KenWillmott/M8-Game-Board/IMG_20230915_113249.jpg

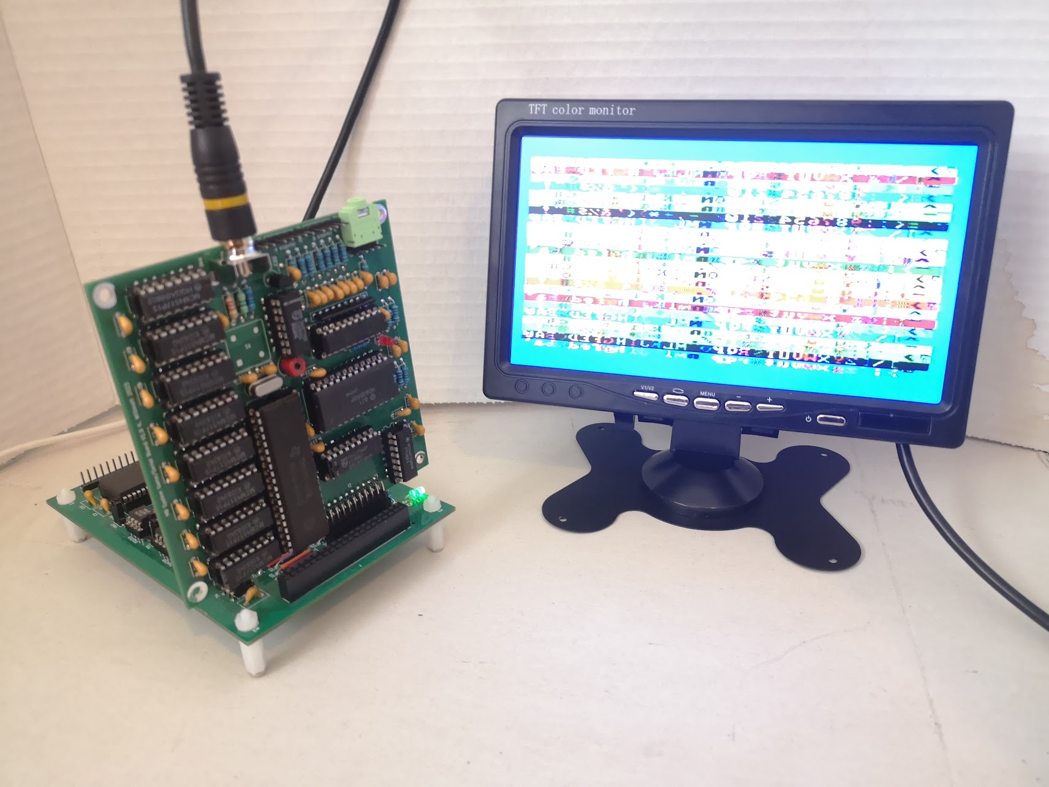
IMG_20230915_113249.jpg
