KenWillmott/M8-Game-Board/IMG_20230915_120120.jpg

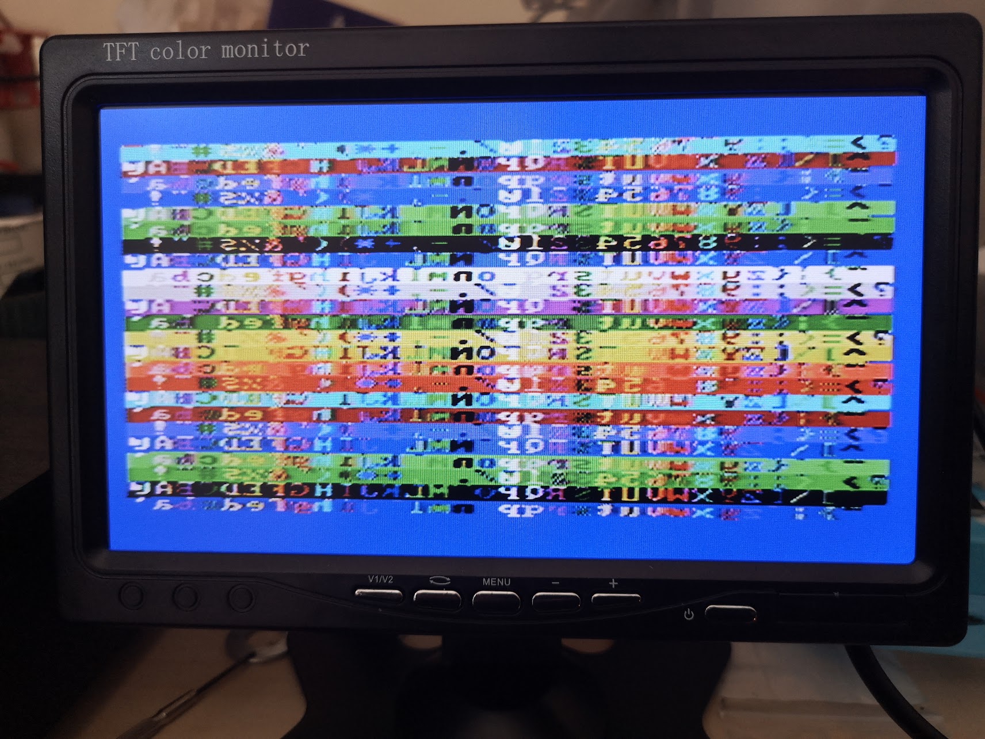
IMG_20230915_120120.jpg
