KenWillmott/M8-Game-Board/README.md

# M8-Game-Board

## Note: This board is deprecated, an improved board is in testing.

See: https://github.com/KenWillmott/M8-Game-Board-V2.1

The M8 Game Board is so named because it combines a video display processor, a sound synthesizer, and dual joystick inputs. These are the main components of a video game. Keyboard input is also possible with the serial chip that is also on board. It also follows the M8 philosophy of using the most advanced ICs that were available at the time, without regard to brand.

The TMS9918A VDP (Video Display Processor) was certainly the IC that brought game features like hardware sprites (up to 32) and using cheap (at the time) dynamic memory. Steve Ciarcia's article about it inspired an Apple II compatible video expansion card that I happened to get a hold of and interfaced to my Ohio Scientific Superboard II. It was lost, and this is a great way to play with it again. It's an amazing chip, and also extremely simple to interface to an 8 bit processor.

The synth was a tough choice because it factors in my judgement of the current availability, combined with interface ease issues. But I played with a prototype and it can make game quality music and effects. It's the Philips SAA1099. The more common AY-8910 was ruled out because of interface issues.

The joystick inputs are just a pair of 4 filtered digital inputs to a latch, with resistor pull ups to the power supply. So they can also be any eight general purpose switches.

The serial interface is an MC6850 or equivalent part. It's a UART but Motorola called it an "ACIA". There are now small USB Host to Serial cards available, it would allow the input from a keyboard and maybe mouse.

One board has been built and tested. Evaluation is on going.

See the wiki for more details:
https://github.com/KenWillmott/M8-Game-Board/wiki
