KenWillmott/M8-Game-Board/motorino-game.pdf

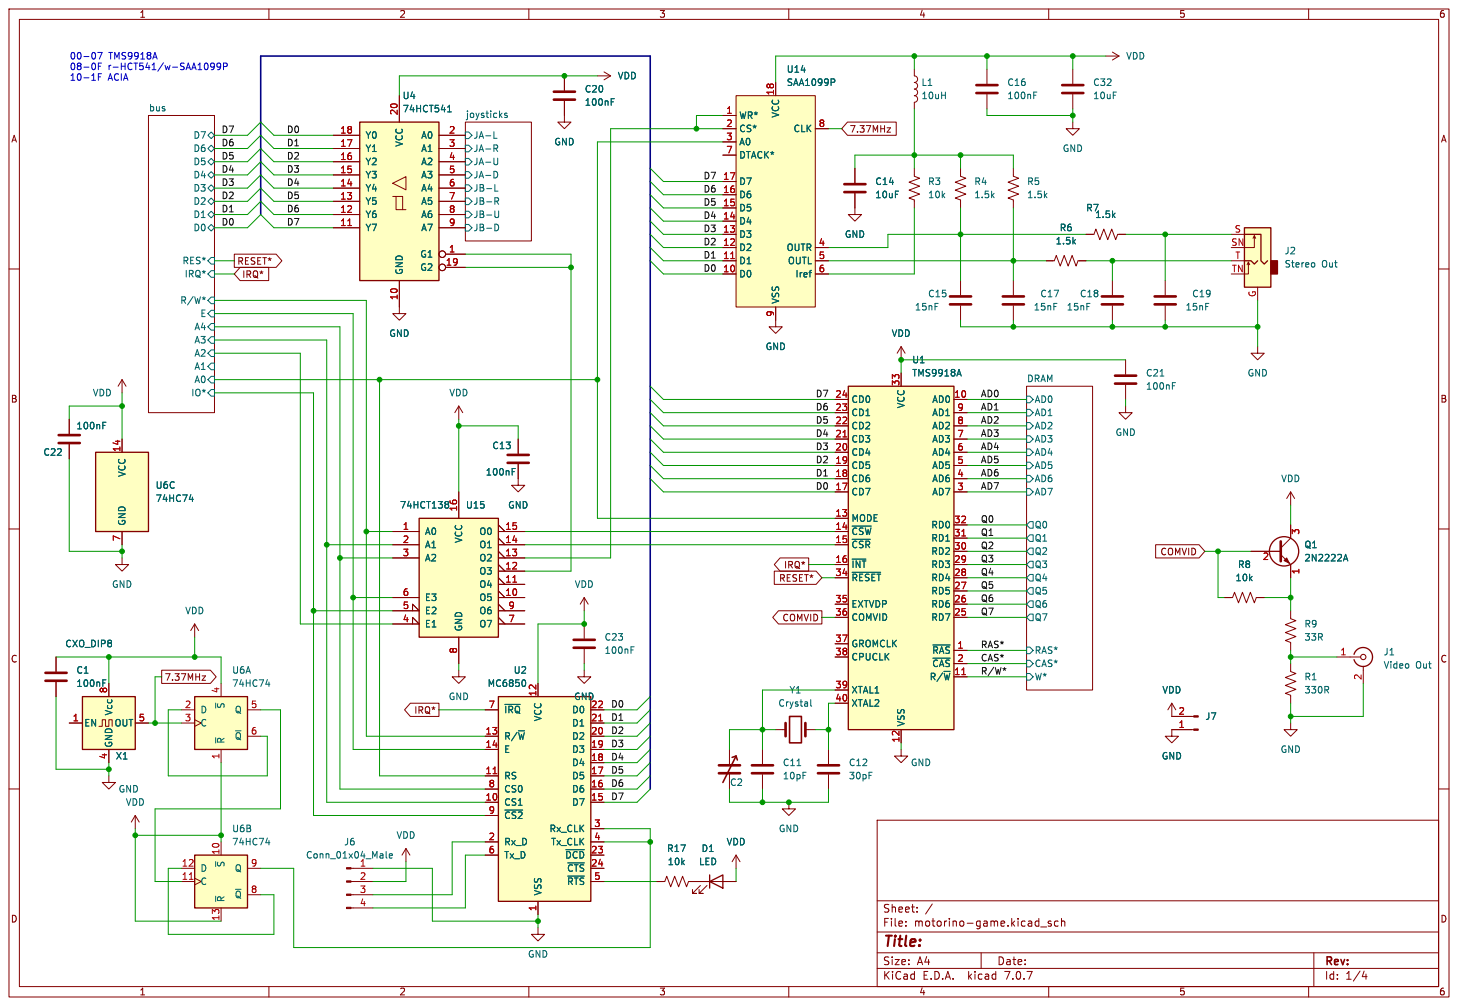
[picture p3: page 1]

Id: 1/4 Title: File: motorino-game.kicad_sch Sheet: /

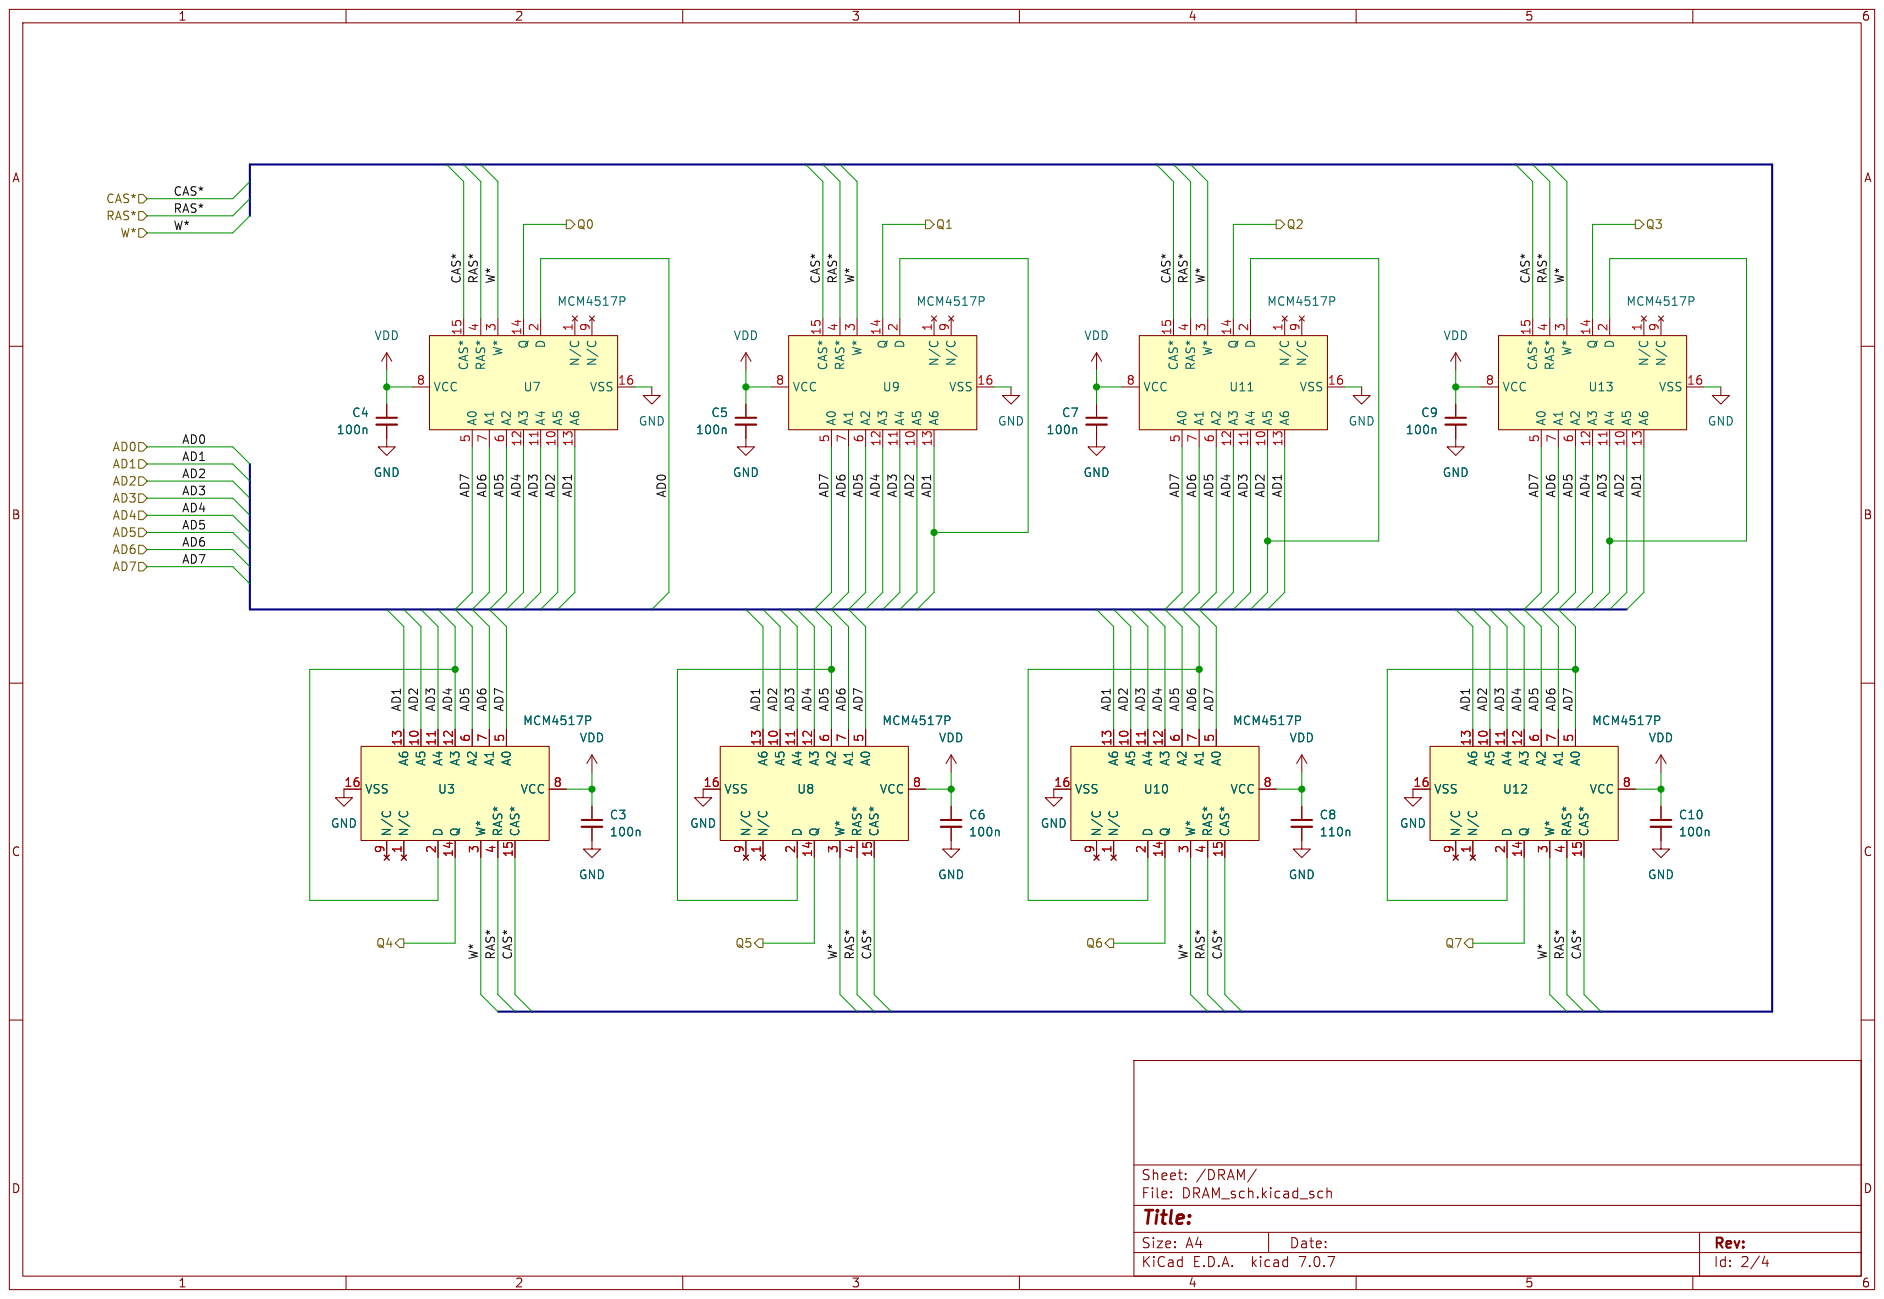
[picture p4: page 2]

Id: 2/4 Title: File: DRAM_sch.kicad_sch Sheet: /DRAM/ N/C

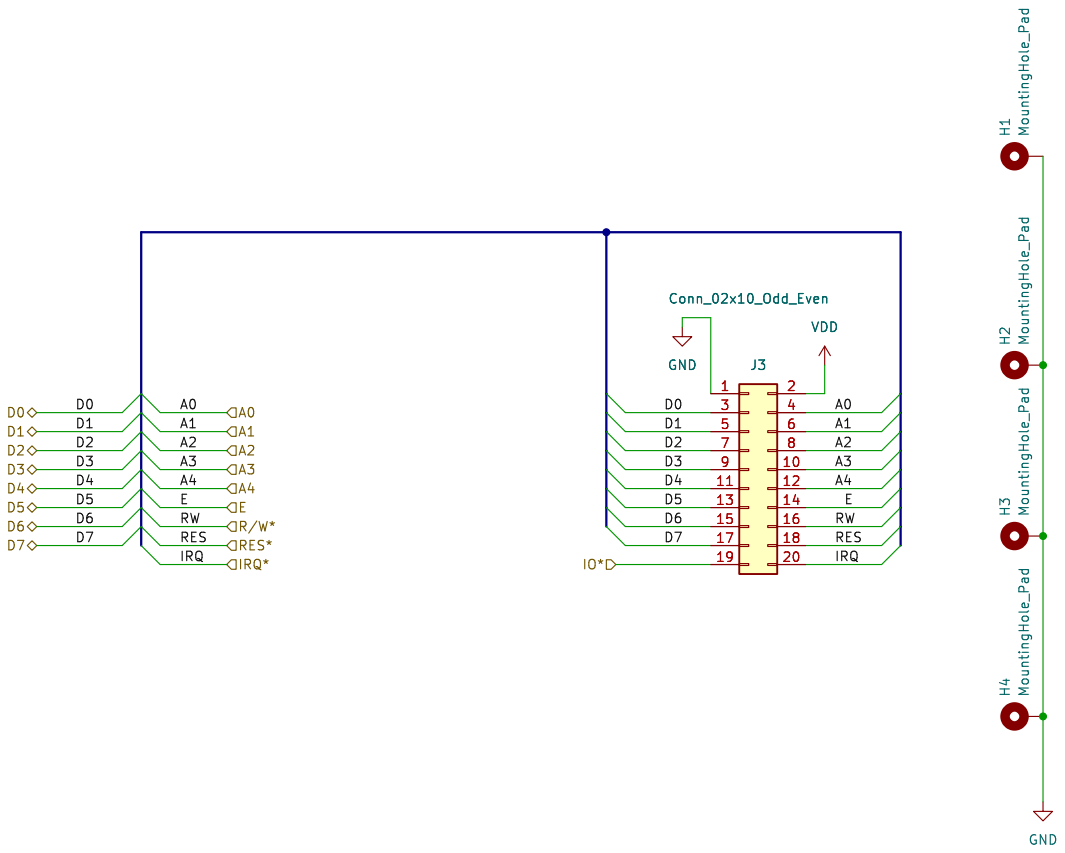
[picture p5: page 3]

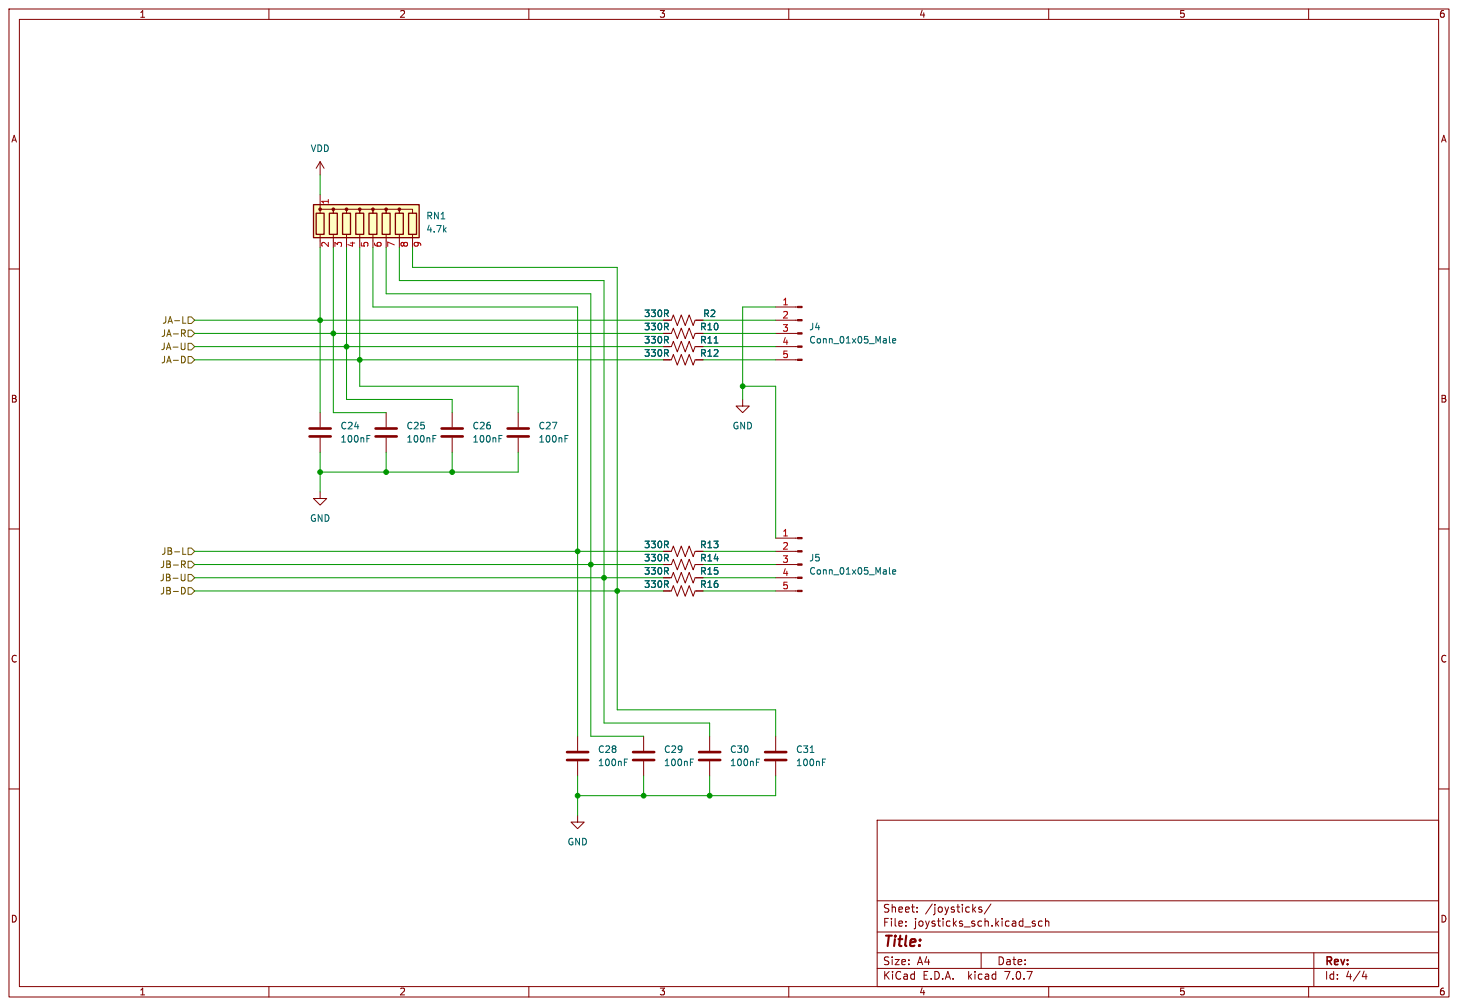
[picture p6: page 4]

Id: 4/4 Title: File: joysticks_sch.kicad_sch Sheet: /joysticks/ C28
