KenWillmott/M8-Game-Board/DRAM_sch.kicad_sch

## KiCad design DRAM_sch.kicad_sch (2023-09-16)

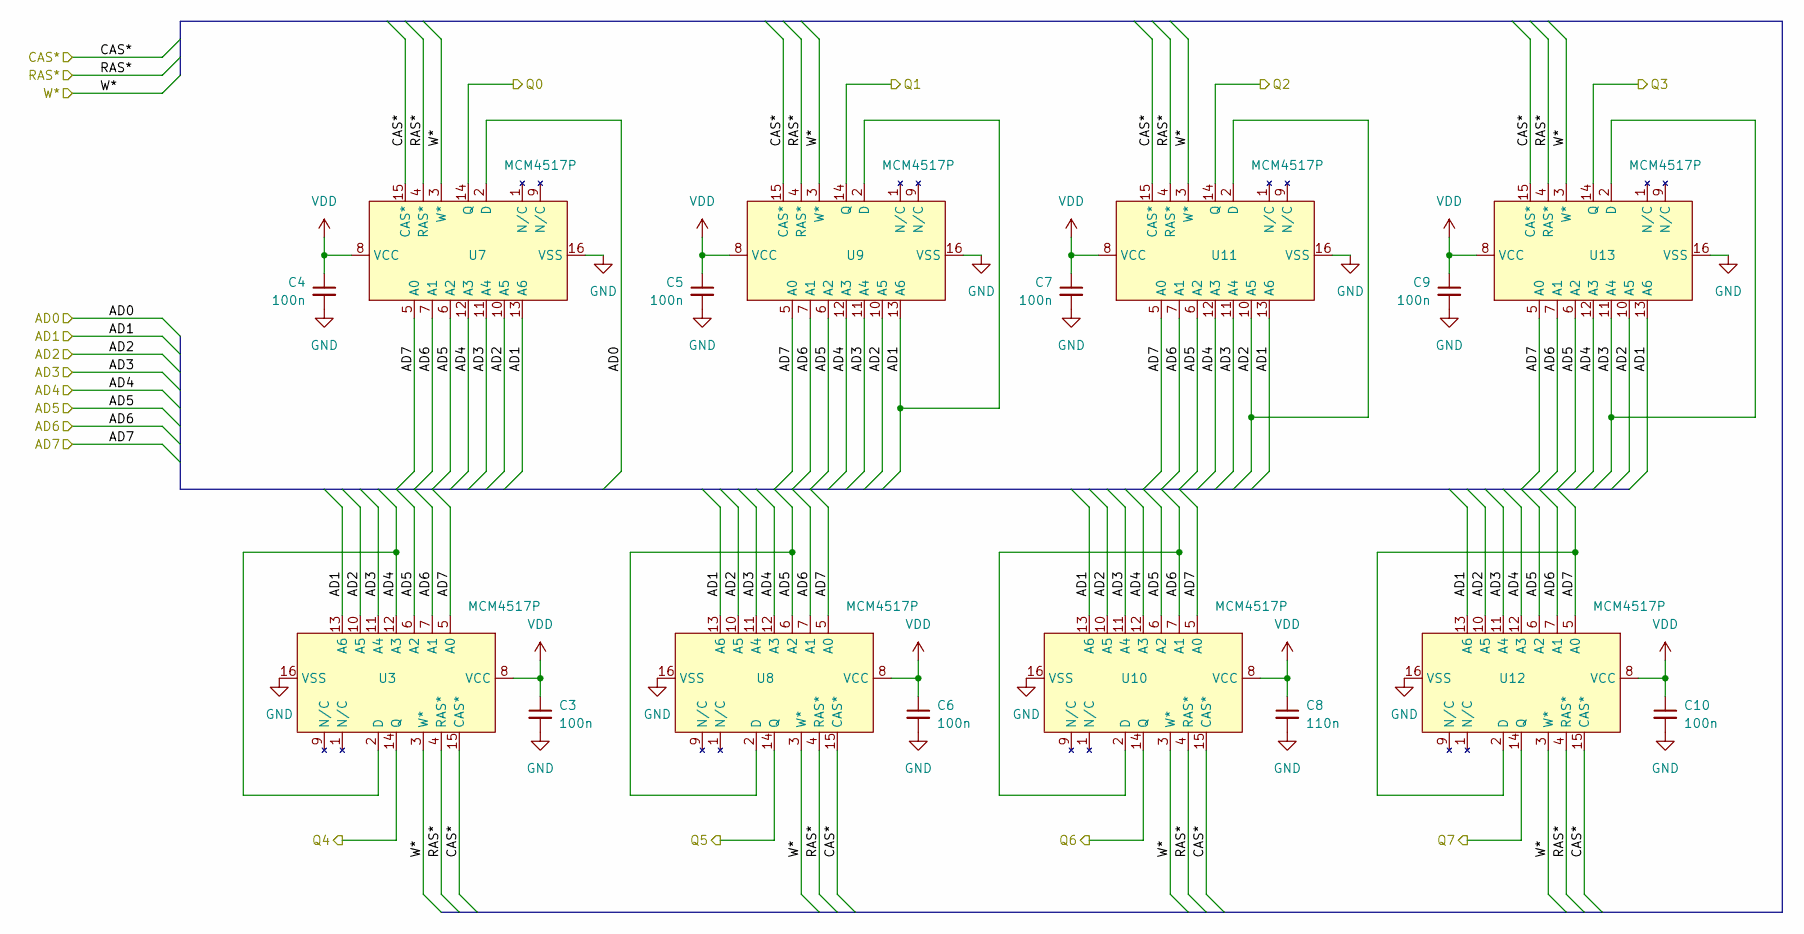
[picture p7: schematic DRAM_sch.kicad_sch]

Parts:
C3, C4, C5, C6, C7, C9, C10: 100n; C_Disc_D5.0mm_W2.5mm_P5.00mm
C8: 110n; C_Disc_D5.0mm_W2.5mm_P5.00mm
U3, U7, U8, U9, U10, U11, U12, U13: MCM4517P; DIP-16_W7.62mm_LongPads

Connections:
AD0: U7.2 (D)
AD1: U3.13 (A6), U7.13 (A6), U8.13 (A6), U9.2 (D), U9.13 (A6), U10.13 (A6), U11.13 (A6), U12.13 (A6), U13.13 (A6)
AD2: U3.10 (A5), U7.10 (A5), U8.10 (A5), U9.10 (A5), U10.10 (A5), U11.2 (D), U11.10 (A5), U12.10 (A5), U13.10 (A5)
AD3: U3.11 (A4), U7.11 (A4), U8.11 (A4), U9.11 (A4), U10.11 (A4), U11.11 (A4), U12.11 (A4), U13.2 (D), U13.11 (A4)
AD4: U3.2 (D), U3.12 (A3), U7.12 (A3), U8.12 (A3), U9.12 (A3), U10.12 (A3), U11.12 (A3), U12.12 (A3), U13.12 (A3)
AD5: U3.6 (A2), U7.6 (A2), U8.2 (D), U8.6 (A2), U9.6 (A2), U10.6 (A2), U11.6 (A2), U12.6 (A2), U13.6 (A2)
AD6: U3.7 (A1), U7.7 (A1), U8.7 (A1), U9.7 (A1), U10.2 (D), U10.7 (A1), U11.7 (A1), U12.7 (A1), U13.7 (A1)
AD7: U3.5 (A0), U7.5 (A0), U8.5 (A0), U9.5 (A0), U10.5 (A0), U11.5 (A0), U12.2 (D), U12.5 (A0), U13.5 (A0)
CAS*: U3.15 (CAS*), U7.15 (CAS*), U8.15 (CAS*), U9.15 (CAS*), U10.15 (CAS*), U11.15 (CAS*), U12.15 (CAS*), U13.15 (CAS*)
GND: C3.2, C4.2, C5.2, C6.2, C7.2, C8.2, C9.2, C10.2, U3.16 (VSS), U7.16 (VSS), U8.16 (VSS), U9.16 (VSS), U10.16 (VSS), U11.16 (VSS), U12.16 (VSS), U13.16 (VSS)
Q0: U7.14 (Q)
Q1: U9.14 (Q)
Q2: U11.14 (Q)
Q3: U13.14 (Q)
Q4: U3.14 (Q)
Q5: U8.14 (Q)
Q6: U10.14 (Q)
Q7: U12.14 (Q)
RAS*: U3.4 (RAS*), U7.4 (RAS*), U8.4 (RAS*), U9.4 (RAS*), U10.4 (RAS*), U11.4 (RAS*), U12.4 (RAS*), U13.4 (RAS*)
VDD: C3.1, C4.1, C5.1, C6.1, C7.1, C8.1, C9.1, C10.1, U3.8 (VCC), U7.8 (VCC), U8.8 (VCC), U9.8 (VCC), U10.8 (VCC), U11.8 (VCC), U12.8 (VCC), U13.8 (VCC)
W*: U3.3 (W*), U7.3 (W*), U8.3 (W*), U9.3 (W*), U10.3 (W*), U11.3 (W*), U12.3 (W*), U13.3 (W*)
