KenWillmott/M8-Game-Board/bus_sch.kicad_sch

## KiCad design bus_sch.kicad_sch (2023-09-16)

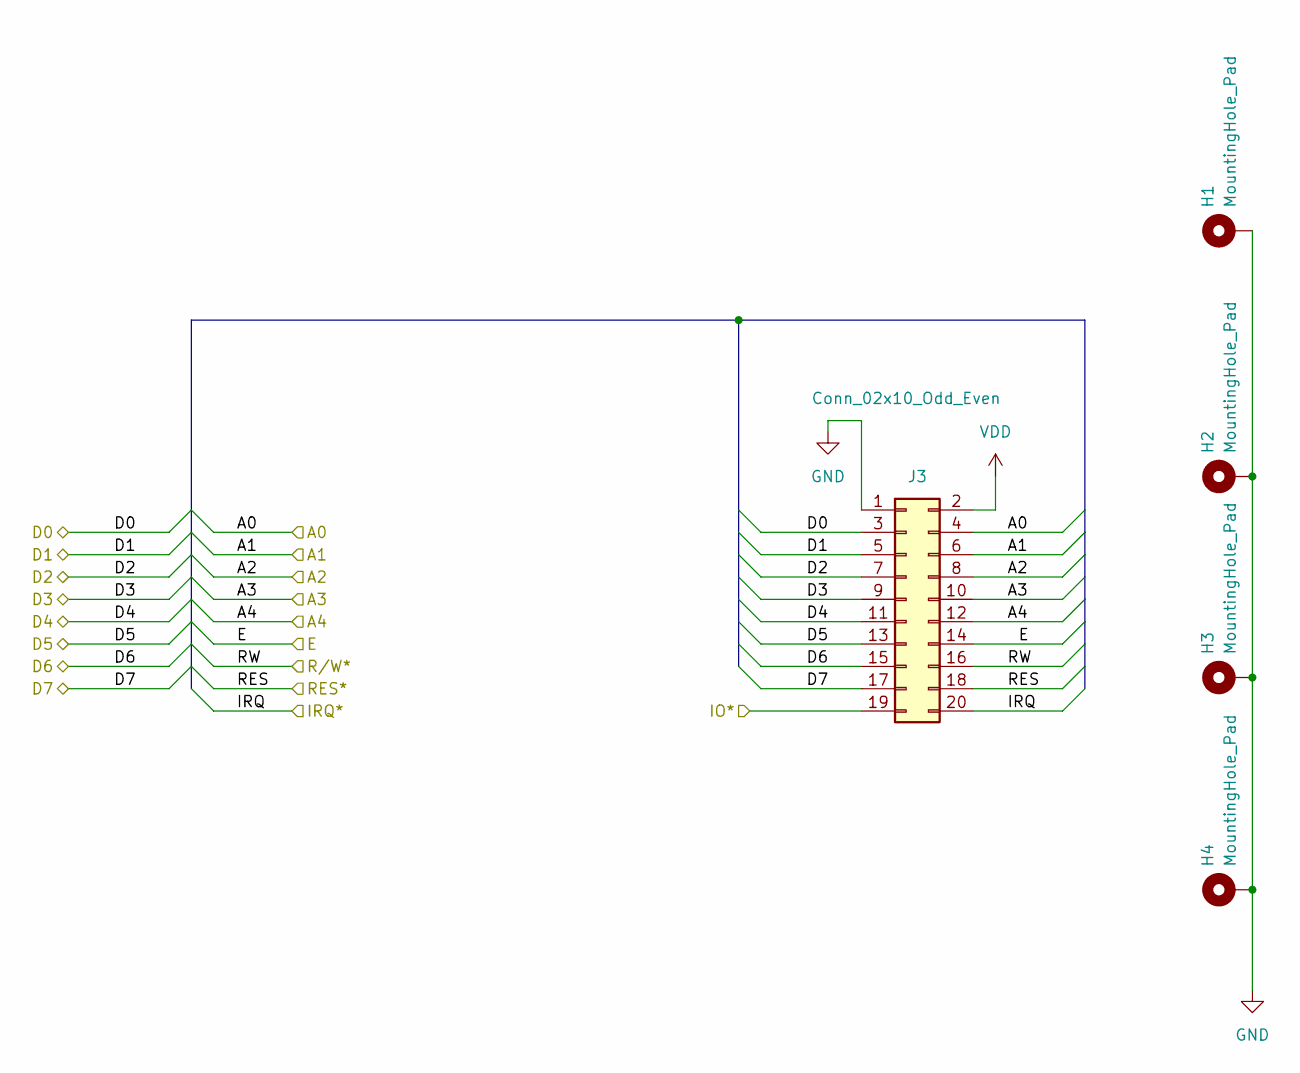
[picture p8: schematic bus_sch.kicad_sch]

Parts:
H1, H2, H3, H4: MountingHole_Pad; MountingHole_3.2mm_M3_Pad
J3: Conn_02x10_Odd_Even; PinHeader_2x10_P2.54mm_Horizontal

Connections:
A0: J3.4
A1: J3.6
A2: J3.8
A3: J3.10
A4: J3.12
D0: J3.3
D1: J3.5
D2: J3.7
D3: J3.9
D4: J3.11
D5: J3.13
D6: J3.15
D7: J3.17
E: J3.14
GND: H1.1, H2.1, H3.1, H4.1, J3.1
IO*: J3.19
IRQ: J3.20
RES: J3.18
RW: J3.16
VDD: J3.2
