KenWillmott/M8-Game-Board/joysticks_sch.kicad_sch

## KiCad design joysticks_sch.kicad_sch (2023-09-16)

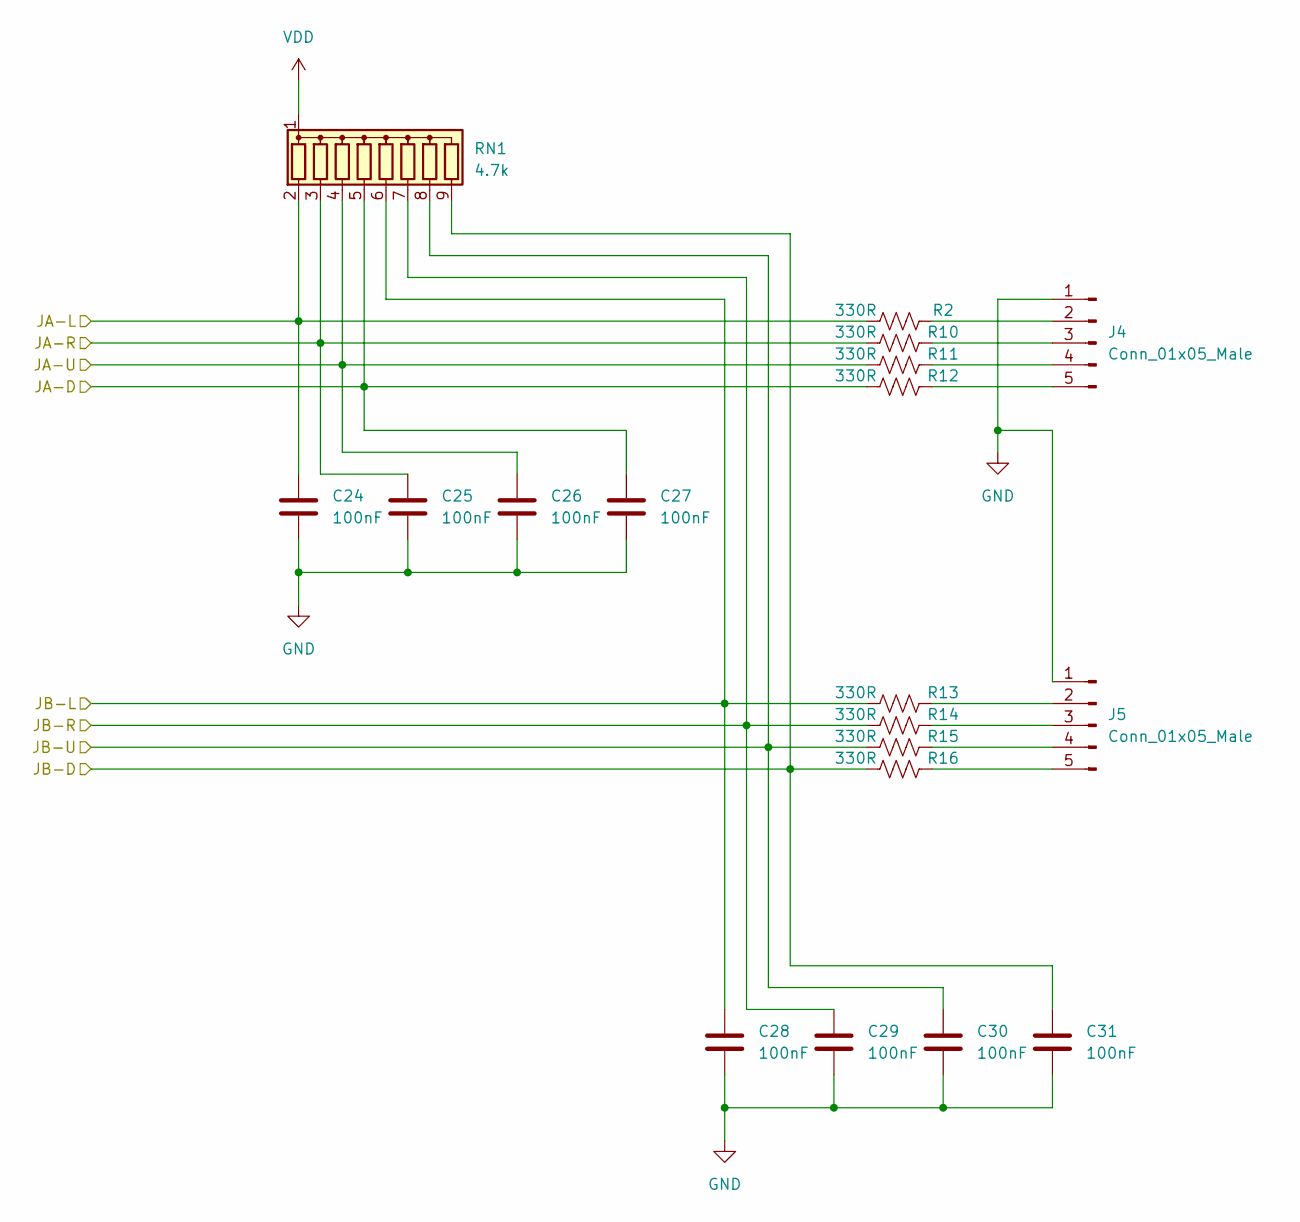
[picture p9: schematic joysticks_sch.kicad_sch]

Parts:
C24, C25, C26, C27, C28, C29, C30, C31: 100nF; C_Disc_D5.0mm_W2.5mm_P5.00mm
J4, J5: Conn_01x05_Male; PinHeader_1x05_P2.54mm_Vertical
R2, R10, R11, R12, R13, R14, R15, R16: 330R; R_Axial_DIN0207_L6.3mm_D2.5mm_P10.16mm_Horizontal
RN1: 4.7k; R_Array_SIP9

Connections:
GND: C24.2, C25.2, C26.2, C27.2, C28.2, C29.2, C30.2, C31.2, J4.1, J5.1
JA-D: C27.1, R12.1, RN1.5 (R4)
JA-L: C24.1, R2.1, RN1.2 (R1)
JA-R: C25.1, R10.1, RN1.3 (R2)
JA-U: C26.1, R11.1, RN1.4 (R3)
JB-D: C31.1, R16.1, RN1.9 (R8)
JB-L: C28.1, R13.1, RN1.6 (R5)
JB-R: C29.1, R14.1, RN1.7 (R6)
JB-U: C30.1, R15.1, RN1.8 (R7)
unnamed: J4.2, R2.2
unnamed: J4.3, R10.2
unnamed: J4.4, R11.2
unnamed: J4.5, R12.2
unnamed: J5.2, R13.2
unnamed: J5.3, R14.2
unnamed: J5.4, R15.2
unnamed: J5.5, R16.2
VDD: RN1.1 (common)
