KenWillmott/M8-Game-Board/motorino-game.kicad_sch

## KiCad design motorino-game.kicad_sch (2023-09-16)

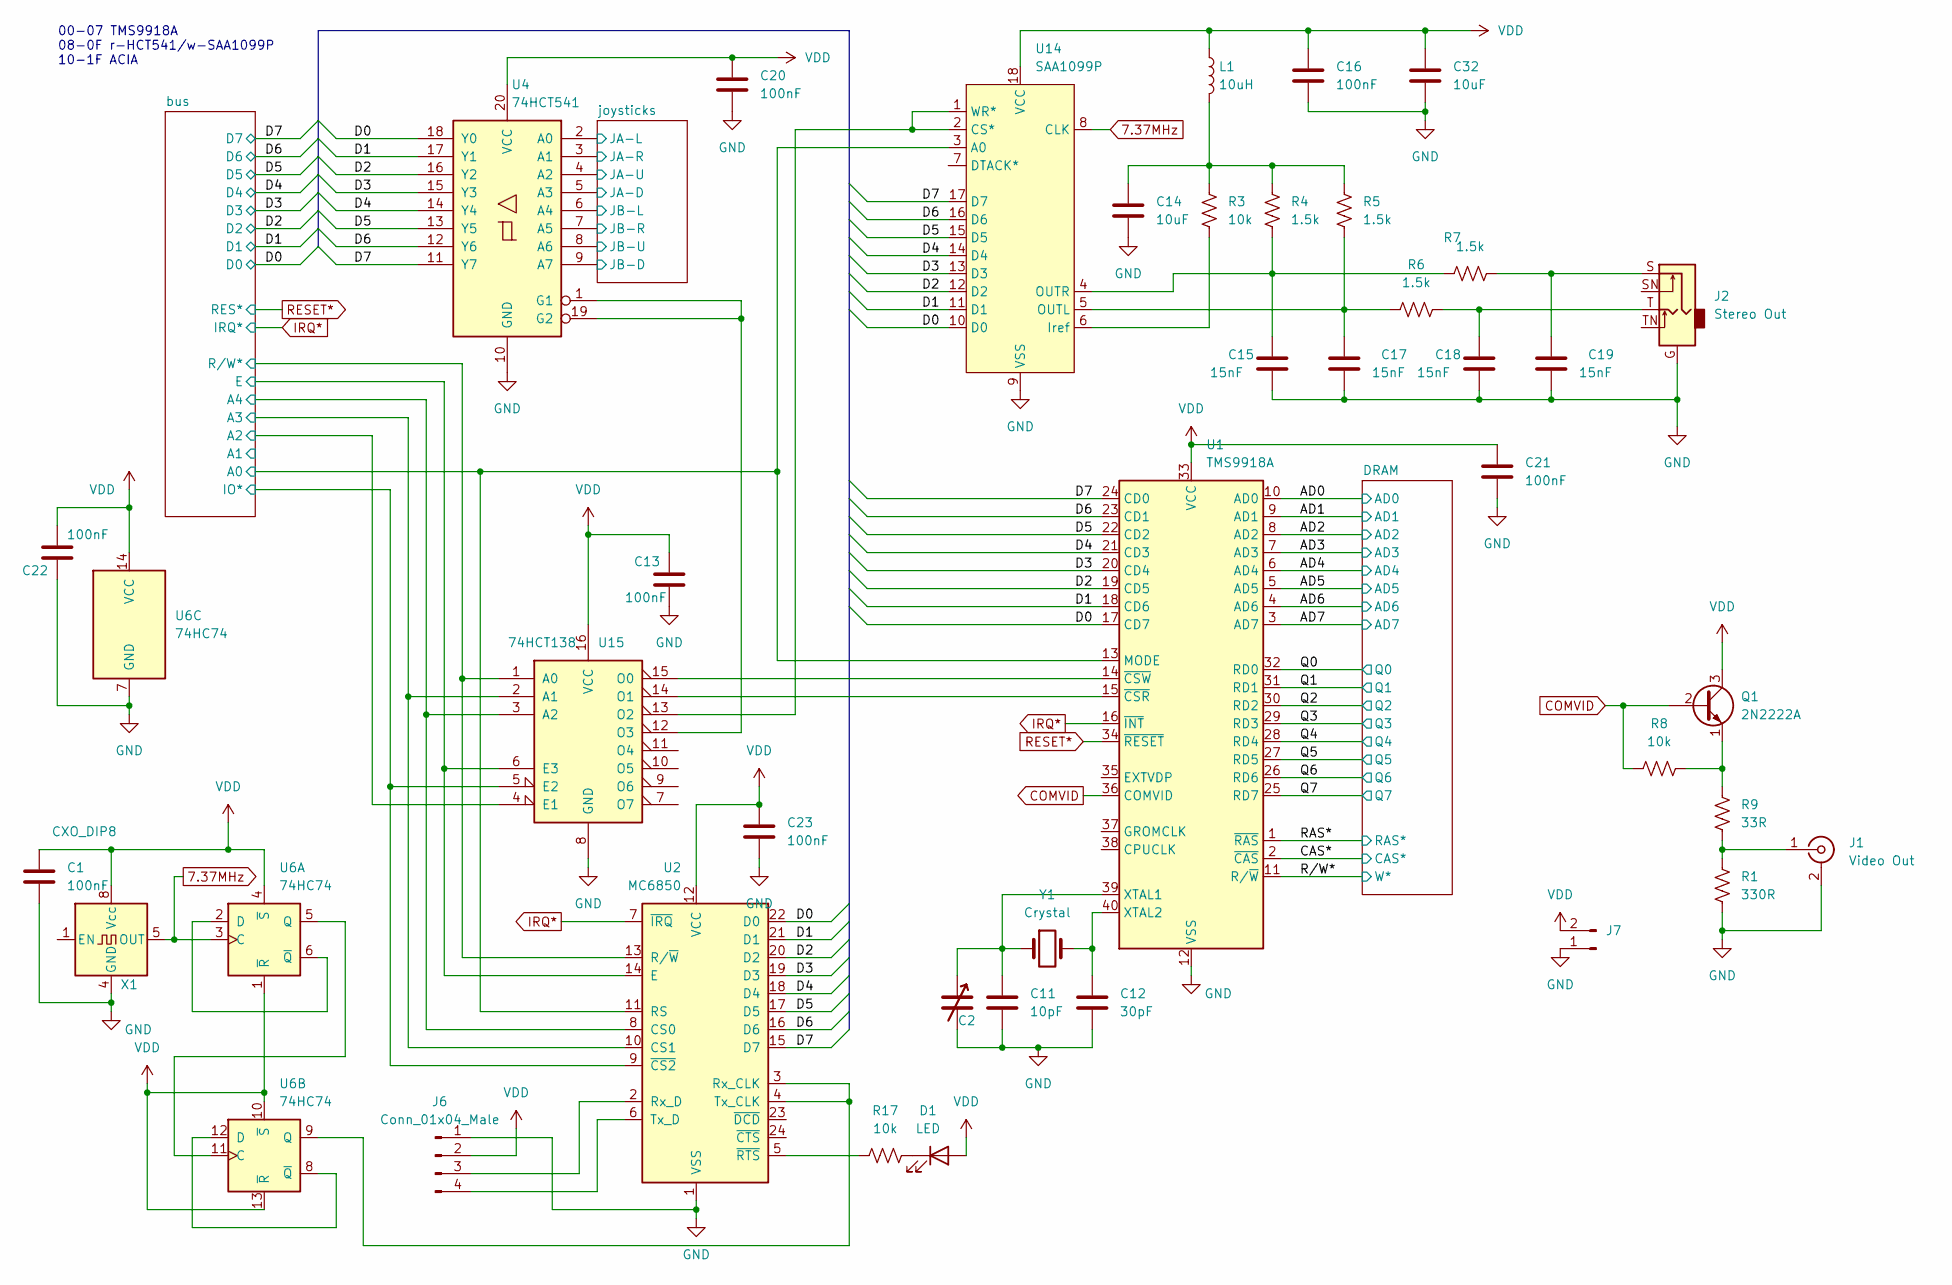
[picture p10: schematic motorino-game.kicad_sch]

Parts:
C1, C13, C16, C20, C21, C22, C23: 100nF; C_Disc_D5.0mm_W2.5mm_P5.00mm
C2: C_Variable; trim cap TH
C11: 10pF; C_Disc_D5.0mm_W2.5mm_P5.00mm
C12: 30pF; C_Disc_D5.0mm_W2.5mm_P5.00mm
C14, C32: 10uF; C_Disc_D5.0mm_W2.5mm_P5.00mm
C15, C17, C18, C19: 15nF; C_Disc_D5.0mm_W2.5mm_P5.00mm
D1: LED; LED_D3.0mm
J1: Video Out; RCA jack
J2: Stereo Out; stereo jack
J6: Conn_01x04_Male; PinHeader_1x04_P2.54mm_Vertical
J7: Conn_01x02_Male; PinHeader_1x02_P2.54mm_Vertical
L1: 10uH; R_Axial_DIN0207_L6.3mm_D2.5mm_P10.16mm_Horizontal
Q1: 2N2222A; TO-92_Inline
R1: 330R; R_Axial_DIN0207_L6.3mm_D2.5mm_P10.16mm_Horizontal
R3, R8, R17: 10k; R_Axial_DIN0207_L6.3mm_D2.5mm_P10.16mm_Horizontal
R4, R5, R6, R7: 1.5k; R_Axial_DIN0207_L6.3mm_D2.5mm_P10.16mm_Horizontal
R9: 33R; R_Axial_DIN0207_L6.3mm_D2.5mm_P10.16mm_Horizontal
U1: TMS9918A; DIP-40_W15.24mm_LongPads
U2: MC6850; DIP-24_W15.24mm_LongPads
U4: 74HCT541; DIP-20_W7.62mm_Socket_LongPads
U6: 74HC74; DIP-14_W7.62mm_LongPads
U14: SAA1099P; DIP-18_W7.62mm_LongPads
U15: 74HCT138; DIP-16_W7.62mm_LongPads
X1: CXO_DIP8; Oscillator_DIP-8
Y1: Crystal; Crystal_HC49-U_Vertical

Connections:
7.37MHz: U6.3 (C), U14.8 (CLK), X1.5 (OUT)
A0: U1.13 (MODE), U2.11 (RS), U14.3 (A0)
A2: U15.4 (E1)
A3: U2.10 (CS1), U15.2 (A1)
A4: U2.8 (CS0), U15.3 (A2)
AD0: U1.10 (AD0)
AD1: U1.9 (AD1)
AD2: U1.8 (AD2)
AD3: U1.7 (AD3)
AD4: U1.6 (AD4)
AD5: U1.5 (AD5)
AD6: U1.4 (AD6)
AD7: U1.3 (AD7)
CAS*: U1.2 (~CAS)
COMVID: Q1.2 (B), R8.1, U1.36 (COMVID)
D0: U1.17 (CD7), U2.22 (D0), U4.18 (Y0), U14.10 (D0)
D1: U1.18 (CD6), U2.21 (D1), U4.17 (Y1), U14.11 (D1)
D2: U1.19 (CD5), U2.20 (D2), U4.16 (Y2), U14.12 (D2)
D3: U1.20 (CD4), U2.19 (D3), U4.15 (Y3), U14.13 (D3)
D4: U1.21 (CD3), U2.18 (D4), U4.14 (Y4), U14.14 (D4)
D5: U1.22 (CD2), U2.17 (D5), U4.13 (Y5), U14.15 (D5)
D6: U1.23 (CD1), U2.16 (D6), U4.12 (Y6), U14.16 (D6)
D7: U1.24 (CD0), U2.15 (D7), U4.11 (Y7), U14.17 (D7)
E: U2.14 (E), U15.6 (E3)
GND: C1.2, C2.2, C11.2, C12.2, C13.2, C14.2, C15.2, C16.2, C17.2, C18.2, C19.2, C20.2, C21.2, C22.2, C23.2, C32.2, J1.2 (Ext), J2.G, J6.1, J7.1, R1.2, U1.12 (VSS), U2.1 (VSS), U4.10 (GND), U6.7 (GND), U14.9 (VSS), U15.8 (GND), X1.4 (GND)
IO*: U2.9 (~CS2), U15.5 (E2)
IRQ*: U1.16 (~INT), U2.7 (~IRQ)
JA-D: U4.5 (A3)
JA-L: U4.2 (A0)
JA-R: U4.3 (A1)
JA-U: U4.4 (A2)
JB-D: U4.9 (A7)
JB-L: U4.6 (A4)
JB-R: U4.7 (A5)
JB-U: U4.8 (A6)
unnamed: C2.1, C11.1, U1.39 (XTAL1), Y1.1
unnamed: C12.1, U1.40 (XTAL2), Y1.2
unnamed: C14.1, L1.2, R3.1, R4.1, R5.1
unnamed: C15.1, R4.2, R7.2, U14.4 (OUTR)
unnamed: C17.1, R5.2, R6.2, U14.5 (OUTL)
unnamed: C18.1, J2.T, R6.1
unnamed: C19.1, J2.S, R7.1
unnamed: D1.1 (K), R17.2
unnamed: J1.1 (In), R1.1, R9.2
unnamed: J6.3, U2.2 (Rx_D)
unnamed: J6.4, U2.6 (Tx_D)
unnamed: Q1.1 (E), R8.2, R9.1
unnamed: R3.2, U14.6 (Iref)
unnamed: R17.1, U2.5 (~RTS)
unnamed: U1.14 (~CSW), U15.15 (O0)
unnamed: U1.15 (~CSR), U15.14 (O1)
unnamed: U2.3 (Rx_CLK), U2.4 (Tx_CLK), U6.9 (Q)
unnamed: U6.2 (D), U6.6 (~Q)
unnamed: U6.5 (Q), U6.11 (C)
unnamed: U6.8 (~Q), U6.12 (D)
unnamed: U14.1 (WR*), U14.2 (CS*), U15.13 (O2)
unnamed: U4.1 (G1), U4.19 (G2), U15.12 (O3)
Q0: U1.32 (RD0)
Q1: U1.31 (RD1)
Q2: U1.30 (RD2)
Q3: U1.29 (RD3)
Q4: U1.28 (RD4)
Q5: U1.27 (RD5)
Q6: U1.26 (RD6)
Q7: U1.25 (RD7)
RAS*: U1.1 (~RAS)
RESET*: U1.34 (~RESET)
R/W*: U1.11 (R/~W), U2.13 (R/~W), U15.1 (A0)
VDD: C1.1, C13.1, C16.1, C20.1, C21.1, C22.1, C23.1, C32.1, D1.2 (A), J6.2, J7.2, L1.1, Q1.3 (C), U1.33 (VCC), U2.12 (VCC), U4.20 (VCC), U6.1 (~R), U6.4 (~S), U6.10 (~S), U6.13 (~R), U6.14 (VCC), U14.18 (VCC), U15.16 (VCC), X1.8 (Vcc)

Notes on the sheet:
00-07 TMS9918A 08-0F r-HCT541/w-SAA1099P 10-1F ACIA
