KenWillmott/M8-Game-Board/(commit log)

2023-09-16 Create README.md
    Introduction to M8 Game Board
2023-09-16 schematic PDF
